bgarberman/IoTMedicine/README.md

# IoTMedicine
Firmware and PCB Design Files for IoT Medicine Monitor
