bgarberman/IoTMedicine/PCB Files/IotMedicine/ESE516_ExampleBaseProject_V1/Project Outputs for ESE516_ExampleBaseProject_V1/BOM/Bill of Materials-ESE516_ExampleBaseProject_V1.xls

Line # | Name | Description | Designator | Quantity | Manufacturer 1 | Manufacturer Part Number 1 | Manufacturer Lifecycle 1 | Supplier 1 | Supplier Part Number 1 | Supplier Unit Price 1 | Supplier Subtotal 1
 | PTS810 SJK 250 SMTR LFS | SWITCH TACTILE SPST-NO 0.05A 16V Tactile Switch SPST-NO Top Actuated Surface Mount | B1 | 1 | ITT C&K | PTS810SJK250SMTRLFS | Volume Production | Digi-Key | CKN10503CT-ND | 0.3 | 0.3
 | Cap | Capacitor | C1, C9 | 2 | Vishay Vitramon | VJ0603Y104KNXAO | Volume Production | Digi-Key | 720-1235-1-ND | 0.85 | 1.7
 | 10nF 16V | CAP 10nF 16V ±10% 0603 (1608 Metric) Thickness 1mm SMD | C4 | 1
 | 100nF 16V | CAP 100nF 16V ±10% 0603 (1608 Metric) Thickness 1mm SMD | C5, C18 | 2 | Kyocera AVX | 0603YC104KAT2A | Volume Production | Digi-Key | 478-1239-1-ND | 0.16 | 0.32
 | 4.7uF 16V | CAP 4.7uF 16V ±10% 0805 (2012 Metric) Thickness 1.45mm SMD | C6 | 1 | Kyocera AVX | 0805YD475KAT2A | Volume Production | Digi-Key | 478-5166-6-ND | 0.79 | 0.79
 | 47pF 16V | CAP 47pF 16V ±0.5pF 0603 (1608 Metric) Thickness 1mm SMD | C7, C8 | 2 | Kyocera AVX | 08051A470JAT2A | Volume Production | Digi-Key | 478-1282-6-ND | 0.19 | 0.38
 | CAP 10uF 16V | CAP 10uF 16V ±10% 0805 (2012 Metric) Thickness 1.45mm SMD | C10, C11, C12 | 3 | KEMET | C0805C106K4PAC | Volume Production
 | CAP 18pF 10V | CAP 18pF 10V ±1% 0805 (2012 Metric) Thickness 0.75mm SMD | C13, C14 | 2 | Vishay Vitramon | VJ0805A180GXQCW1BC | Volume Production | Digi-Key | 720-1709-6-ND | 0.29 | 0.58
 | CAP 1uF 16V | CAP 1uF 16V ±10% 0603 (1608 Metric) Thickness 1mm SMD | C15 | 1 | Yageo | CC0603KRX5R7BB105 | Volume Production | Digi-Key | 311-1444-1-ND | 0.18 | 0.18
 | Cap | Capacitor | C19, C21 | 2 | Murata | GRM21BR60J226ME39L | Volume Production | Digi-Key | 490-1719-1-ND | 0.46 | 0.92
 | Cap | Capacitor | C20 | 1 | Murata | GRM188R60J106ME47D | Volume Production | Future Electronics | GRM188R60J106ME47D-CUTT | 0.0834 | 0.0834
 | Cap | Capacitor | C22, C23 | 2 | Murata | GRM1885C1H221JA01D | Volume Production | Digi-Key | 490-1435-1-ND | 0.11 | 0.22
 | Cap | Capacitor | C24 | 1 | KEMET | C0603X104K5RACTU | Volume Production | Digi-Key | 399-7969-1-ND | 0.21 | 0.21
 | Cap | 4.7 uF 10V 0603 | C25 | 1 | TDK | C1608X7S1A475K080AC | Volume Production | Mouser | 810-C1608X7S1A475KAC | 0.29 | 0.29
 | Cap | Capacitor | C26 | 1 | Murata | GRM188R60J226MEA0D | Volume Production | Digi-Key | 490-7611-1-ND | 0.26 | 0.26
 | Cap | Capacitor | C27 | 1 | Murata | GRM21BR60G107ME15L | Volume Production | Digi-Key | 490-10510-6-ND | 0.97 | 0.97
 | Cap | Capacitor | C28 | 1 | Murata | GRM21BR60J226ME39L | Volume Production | Digi-Key | 490-1719-1-ND | 0.46 | 0.46
 | PRTR5V0U2X,215 | Ultra Low Capacitance Double Rail-to-Rail ESD Protection Diode, 5.5 V, 1 pF, -40 to 85 degC, 4-Pin SOT143B, RoHS, Tape and Reel | D1 | 1 | NXP Semiconductors | PRTR5V0U2X,215 | Volume Production | Digi-Key | 1727-3884-6-ND | 0.55 | 0.55
 | RGB LED | RGB LED (THT) | D2 | 1 | Kingbright | WP154A4SEJ3VBDZGC/CA | Unknown | Digi-Key | 754-2153-ND
 | LTST-C191KGKT | Chip LED, Green, 574 nm, 40 pF, -55 to 85 degC, 2-Pin SMD, RoHS, Tape and Reel | DS1 | 1 | Vishay Lite-On | LTST-C191KGKT | Volume Production | Digi-Key | 160-1446-1-ND | 0.29 | 0.29
 | BLM21PG221SN1D | Chip Ferrite Bead for Power Lines, 220 Ohm, 2000 mA, -55 to 125 degC, 2 x 1.25 x 1.05 mm SMD, Tape and Reel | FB1, FB2, FB3 | 3 | Murata | BLM21PG221SN1D | Volume Production | Digi-Key | 490-1054-6-ND | 0.1 | 0.3
 | ZX62R-B-5P | Connector; USBMicro-B,Reverse type, SMT; 5 Position; Right Angle | J1 | 1 | Hirose | ZX62R-B-5P(30) | Volume Production | Digi-Key | H125274DKR-ND | 1.02 | 1.02
 | Inductor | Inductor | L1 | 1 | Murata | DFE252012F-1R0M=P2 | Volume Production | Digi-Key | 490-13053-1-ND | 0.67 | 0.67
 | Speaker | Speaker 3" Diameter 4 Ohm 3 Watt | LS1 | 1 | Adafruit Industries | 1314 | Unknown | Digi-Key | 1528-2435-ND | 1.95 | 1.95
 | NPN | NPN Bipolar Transistor | Q1, Q2, Q3 | 3 | Diodes Zetex | DNBT8105-7 | Volume Production | Digi-Key | DNBT8105DIDKR-ND | 0.36 | 1.08
 | 27R 1% | 27R 0.1W 1% 0603 (1608 Metric) SMD | R1, R2, R17, R18, R19 | 5 | Yageo | RC0603FR-0727RL | Volume Production | Digi-Key | 311-27.0HRCT-ND | 0.024 | 0.24
 | 1K | 1K 0.1W 1% 0603 (1608 Metric) SMD | R3, R5, R20 | 3 | Panasonic | ERJ3EKF1001V | Volume Production | Digi-Key | P1.00KHCT-ND | 0.1 | 0.3
 | Jumper | Jumper 0603 (1608 Metric) | R4, R8, R12, R13, R14 | 5 | Bourns | CR0603-J/-000ELF | Volume Production | Digi-Key | CR0603-J/-000ELFDKR-ND | 0.016 | 0.16
 |  | Resistor | R6, R9, R10, R11, R33 | 5 | Vishay Dale | TNPW060310K0BEEA | Volume Production | Digi-Key | TNP10.0KAADKR-ND | 0.65 | 3.25
 | 39R | 39R 0.125W 5% 0805 (2012 Metric) SMD | R7 | 1 | Yageo | RC0805JR-0739RL | Volume Production | Digi-Key | 311-39ARDKR-ND | 0.1 | 0.1
 | 10K | Resistor | R15, R16 | 2 | Vishay Dale | TNPW060310K0BEEA | Volume Production | Digi-Key | TNP10.0KAADKR-ND | 0.65 | 1.3
 | Res1 | Resistor | R21, R22, R23, R27, R28, R29 | 6 | Yageo | RC0603FR-071KL | Volume Production | Digi-Key | 311-1.00KHRDKR-ND | 0.024 | 0.24
 | Res1 | Resistor | R24, R25, R26 | 3 | Panasonic | ERA6AEB101V | Volume Production | Digi-Key | P100DACT-ND | 0.36 | 1.08
 | 100 | Resistor (100) | R30, R32 | 2 | Panasonic | ERA6AEB101V | Volume Production | Digi-Key | P100DACT-ND | 0.36 | 0.72
 | RPot | Potentiometer | R31 | 1 | Bourns | 3310Y-001-103L | Volume Production | Digi-Key | 3310Y-001-103L-ND | 2.9 | 2.9
 | Res1 | Resistor | R35 | 1 | Vishay Dale | CRCW0402100KFKEDHP | Volume Production | Digi-Key | 541-100KYDKR-ND | 0.15 | 0.15
 | Res1 | Resistor | R36 | 1 | Panasonic | ERJ6ENF4533V | Volume Production | Digi-Key | P453KCCT-ND | 0.1 | 0.1
 | 30k | Resistor | R37 | 1 | Panasonic | ERA-6AEB303V | Volume Production | Digi-Key | P30KDACT-ND | 0.36 | 0.36
 | FSR | Force Sensing Resistor | R38 | 1 | Adafruit Industries | 1075 | Unknown | Arrow | 1075 | 10.2 | 10.2
 | 150080SS75000 | SMD mono-color Chip LED, WL-SMCW, Super Red | Red1 | 1 | Wurth Electronics | 150080SS75000 | Volume Production
 | 104031-0811 | Micro SD Card, RA, -25 to 85 degC, 8-Pin SMD, RoHS, Tape and Reel | SD1 | 1 | Molex | 104031-0811 | Volume Production | Digi-Key | WM6357CT-ND | 2.02 | 2.02
 | FT234XD-R | FT234XD USB to BASIC UART IC, -40 to +85 degC, 12-Pin DFN, Pb-Free, Tape and Reel | U1 | 1 | FTDI | FT234XD-R | Volume Production | Digi-Key | 768-1178-6-ND | 2.04 | 2.04
 | 20021111-00010T4LF | CONN HEADER 10POS UNSHD VERT T/H | U2 | 1 | Amphenol FCI | 20021111-00010T4LF | Volume Production | Digi-Key | 609-3712-ND | 0.67 | 0.67
 | SAMW25H18-MR510PB | RF TXRX MODULE WIFI TRACE ANT | U3 | 1 | Microchip / Atmel | ATSAMW25H18-MR510PB | Volume Production | Digi-Key | ATSAMW25H18-MR510PB-ND | 19.15 | 19.15
 | AT25DF081A-SSH-T | IC FLASH 8MBIT 100MHZ 8SOIC | U4 | 1 | Adesto Technologies | AT25DF081A-SSH-T | Not Recommended for New Design | Digi-Key | 1265-1166-1-ND | 1.26 | 1.26
 | Class D Amp | 2.5W Filterless Class-D Mono Audio Amplifier | U5 | 1 | Diodes | PAM8302AASCR | Volume Production | Digi-Key | PAM8302AASCRDICT-ND | 0.63 | 0.63
 | Real-Time Clock | Extremely Accurate I2C-Integrated RTC/TCXO/Crystal | U6 | 1 | Maxim | DS3231S#T&R | Volume Production | Digi-Key | DS3231S#T&RCT-ND | 7.87 | 7.87
 | TLV62568DRL | This is a buck/boost converter designed by Texas Instruments | U9 | 1 | Texas Instruments | TLV62568ADRLR | Unknown | Digi-Key | 296-50407-1-ND | 1.14 | 1.14
 | TLE2426CDR | Rail Splitter IC | U10 | 1 | Texas Instruments | TLE2426CDR | Volume Production | Digi-Key | 296-26774-1-ND | 2.14 | 2.14
 | 14340272-32.768KHz | Crystal, 32.768 KHz, -40 to 85 degC, 3.2 x 1.5 x 0.9 mm SMD | X1 | 1 | Abracon | ABS09-32.768KHZ-T | Volume Production | Digi-Key | 535-9539-1-ND | 1.23 | 1.23
