bgarberman/IoTMedicine/PCB Files/IotMedicine/ESE516_ExampleBaseProject_V1/Project Outputs for ESE516_ExampleBaseProject_V1/Job1.PDF

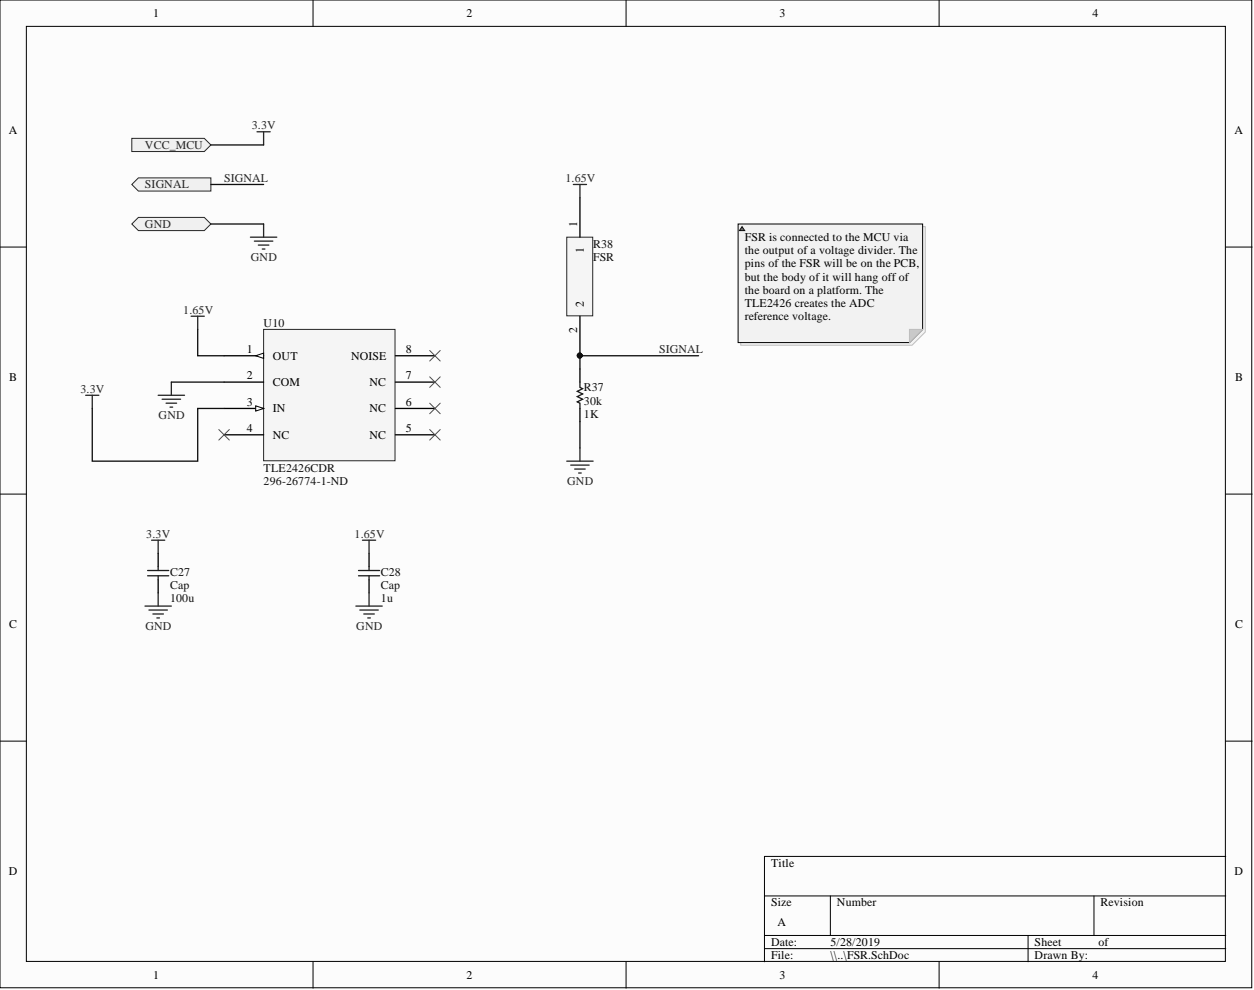
[picture p1: page 2]

FSR is connected to the MCU via
the output of a voltage divider. The
pins of the FSR will be on the PCB,
but the body of it will hang off of
the board on a platform. The
TLE2426 creates the ADC
reference voltage.

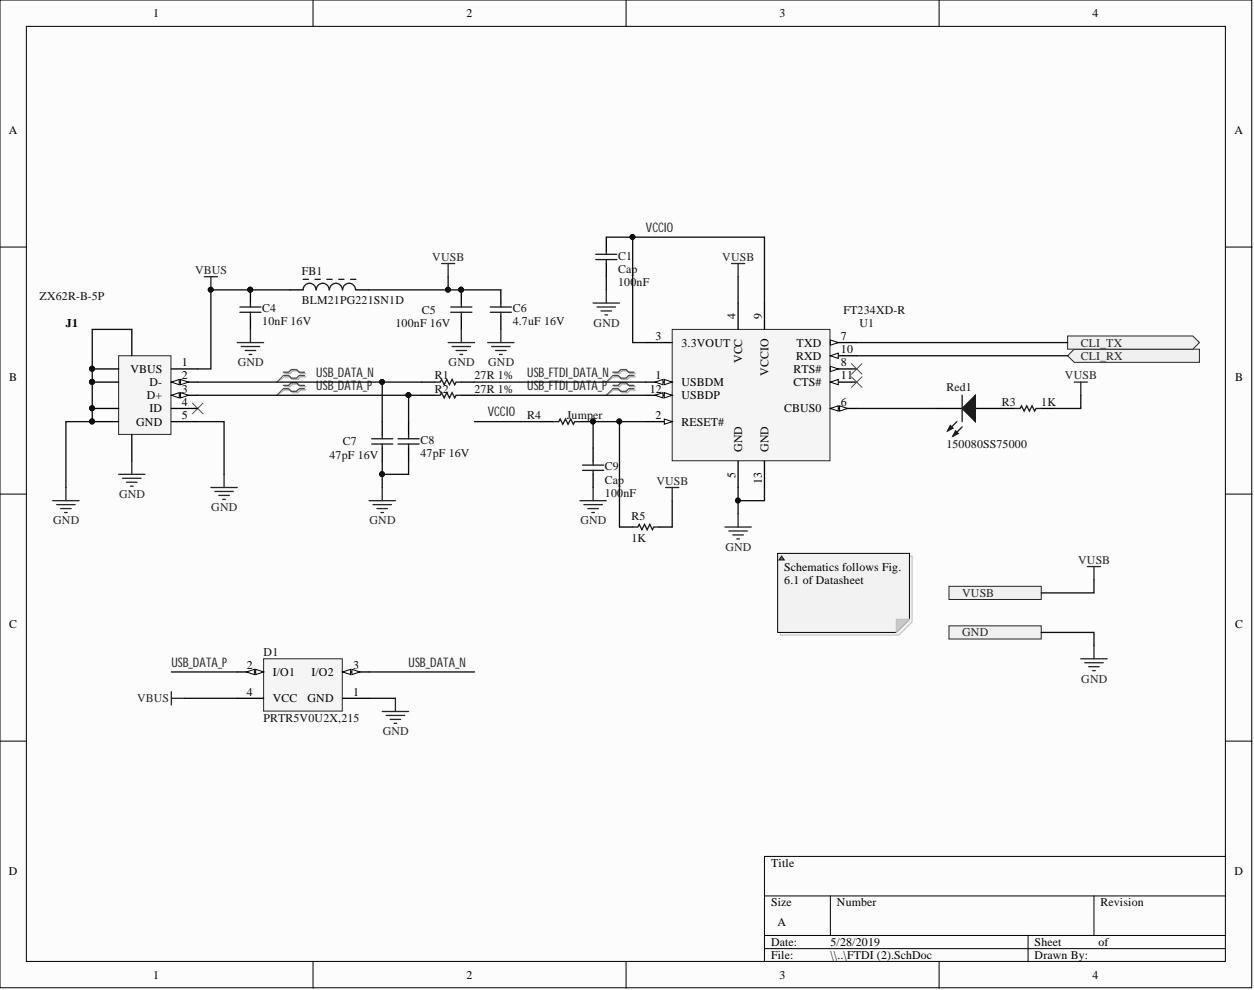
[picture p2: page 3]

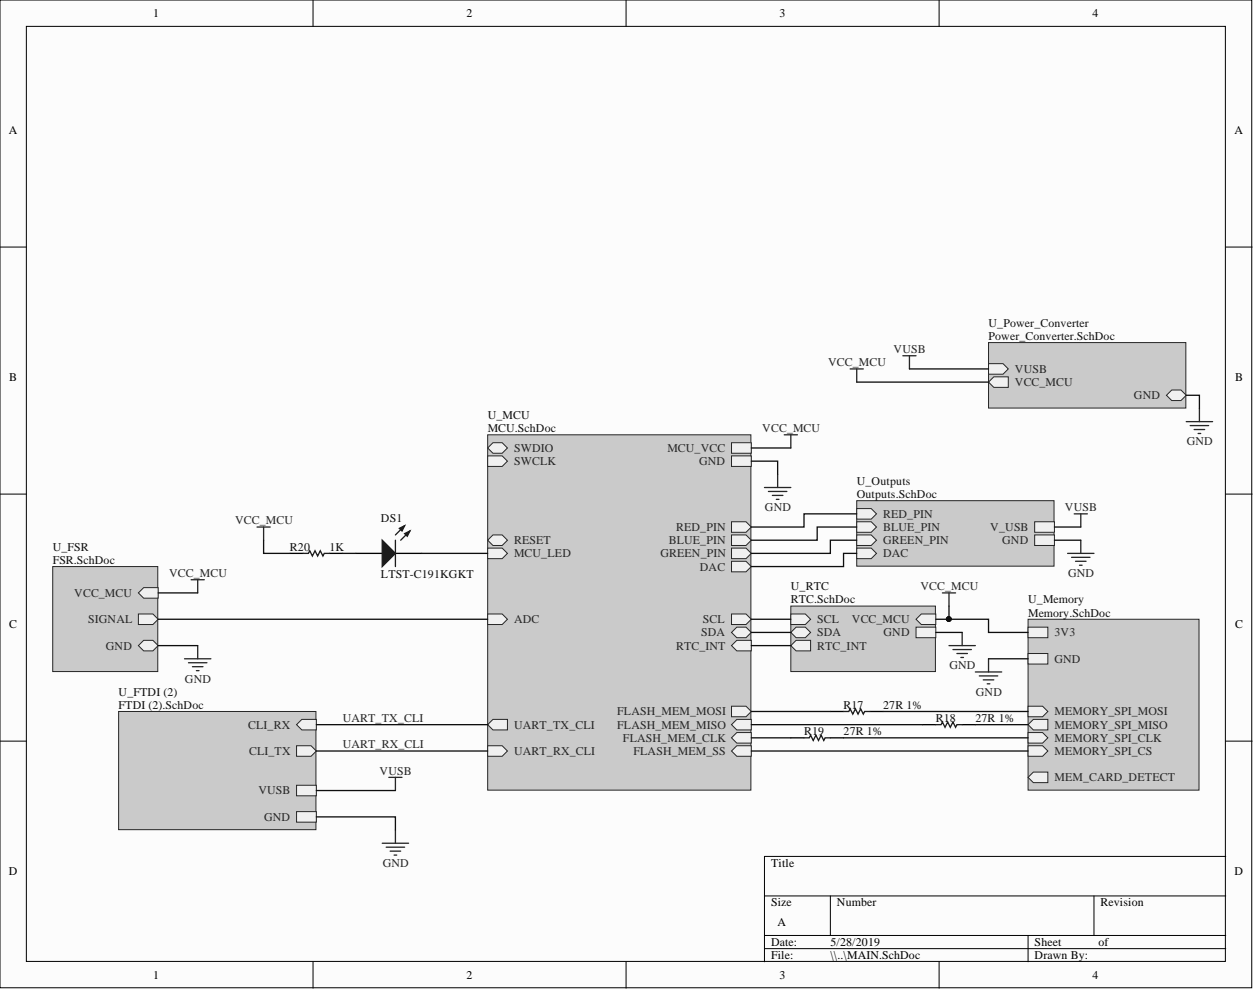
[picture p3: page 4]

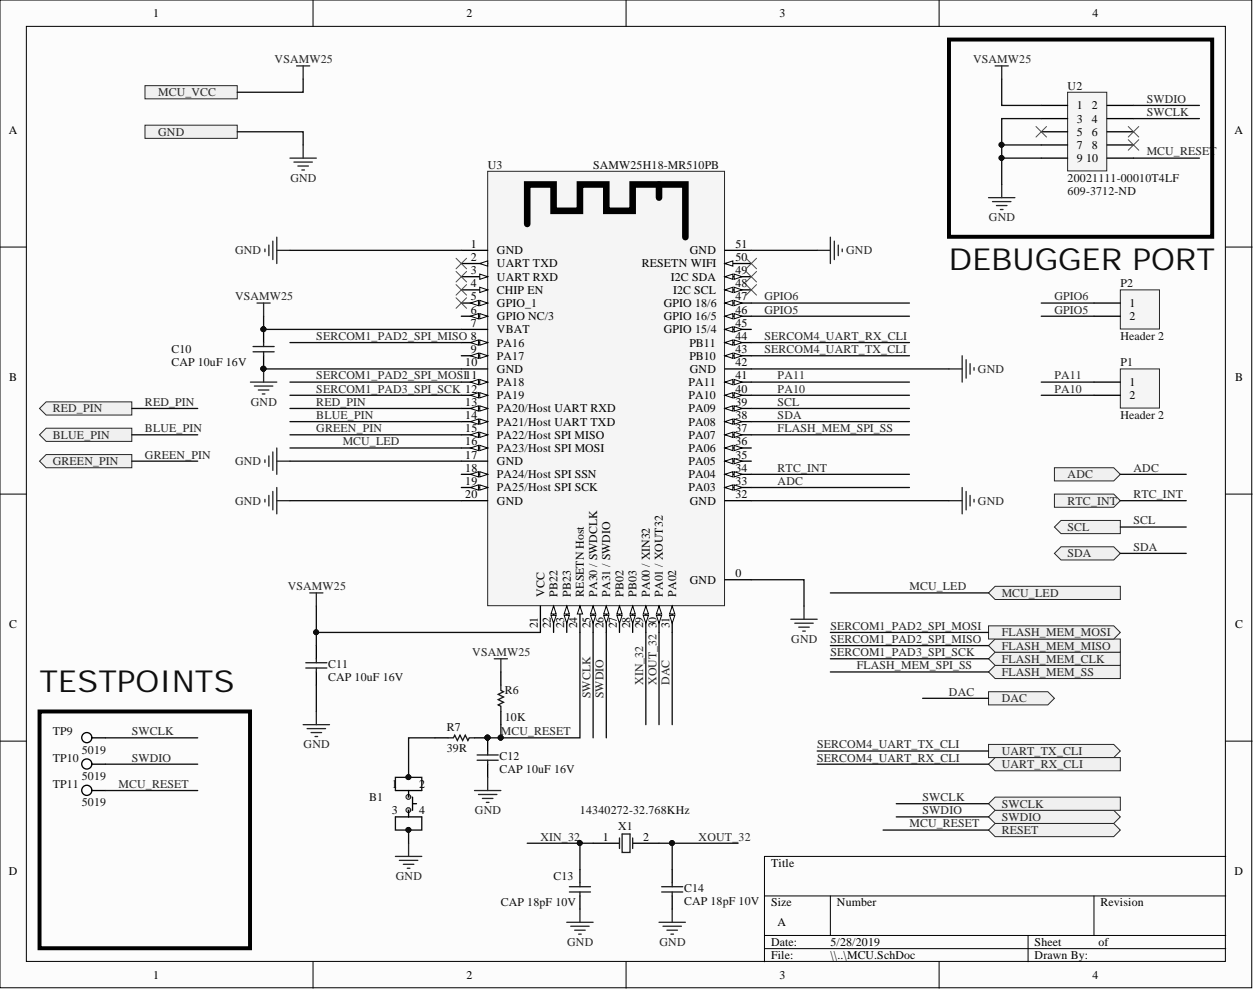
[picture p4: page 5]

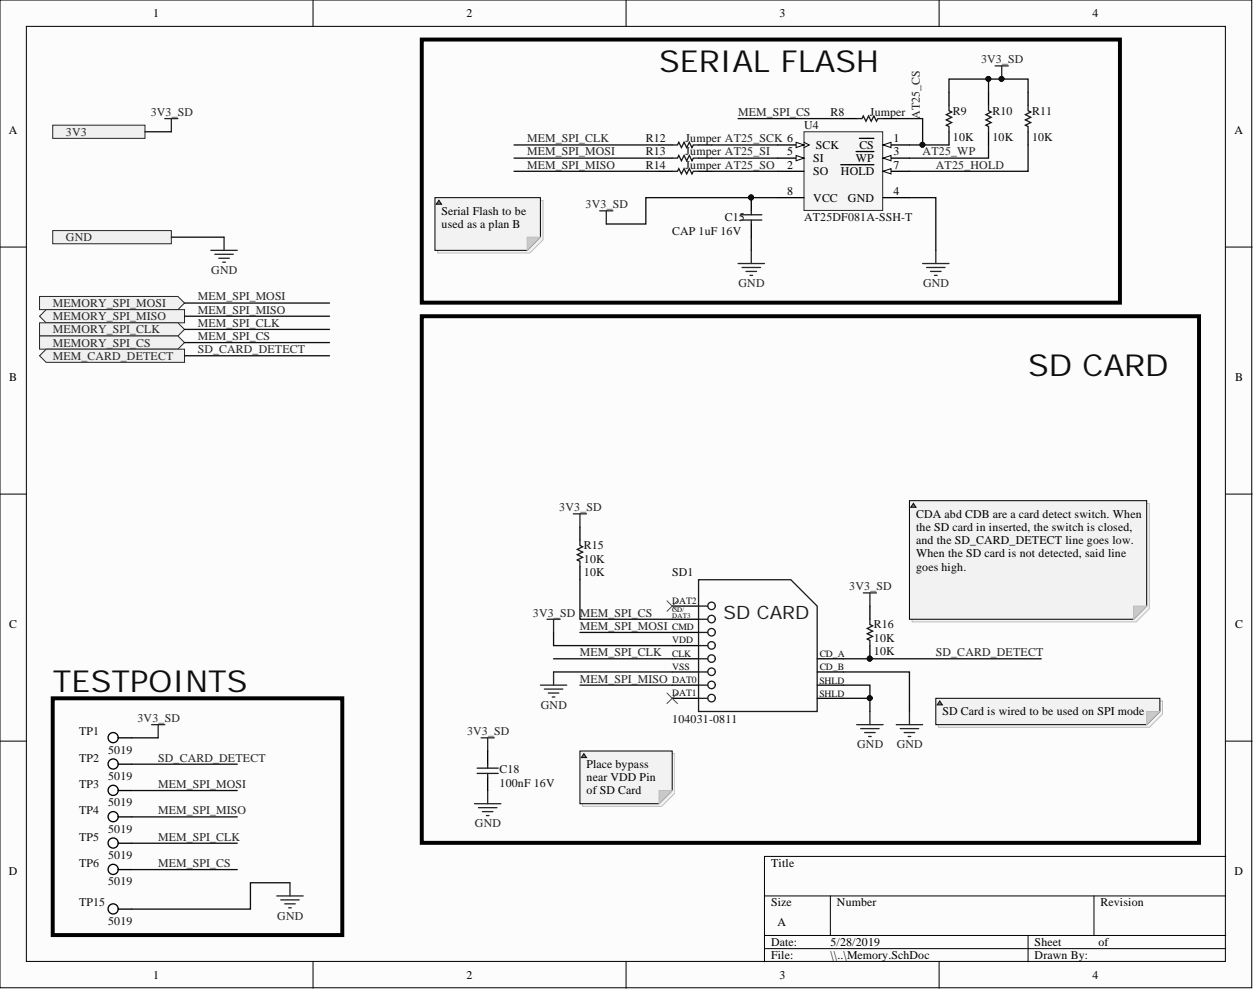
[picture p5: page 6]

Serial Flash to be
used as a plan B

CDA abd CDB are a card detect switch. When
the SD card in inserted, the switch is closed,
and the SD_CARD_DETECT line goes low.
When the SD card is not detected, said line
goes high.

SD Card is wired to be used on SPI mode

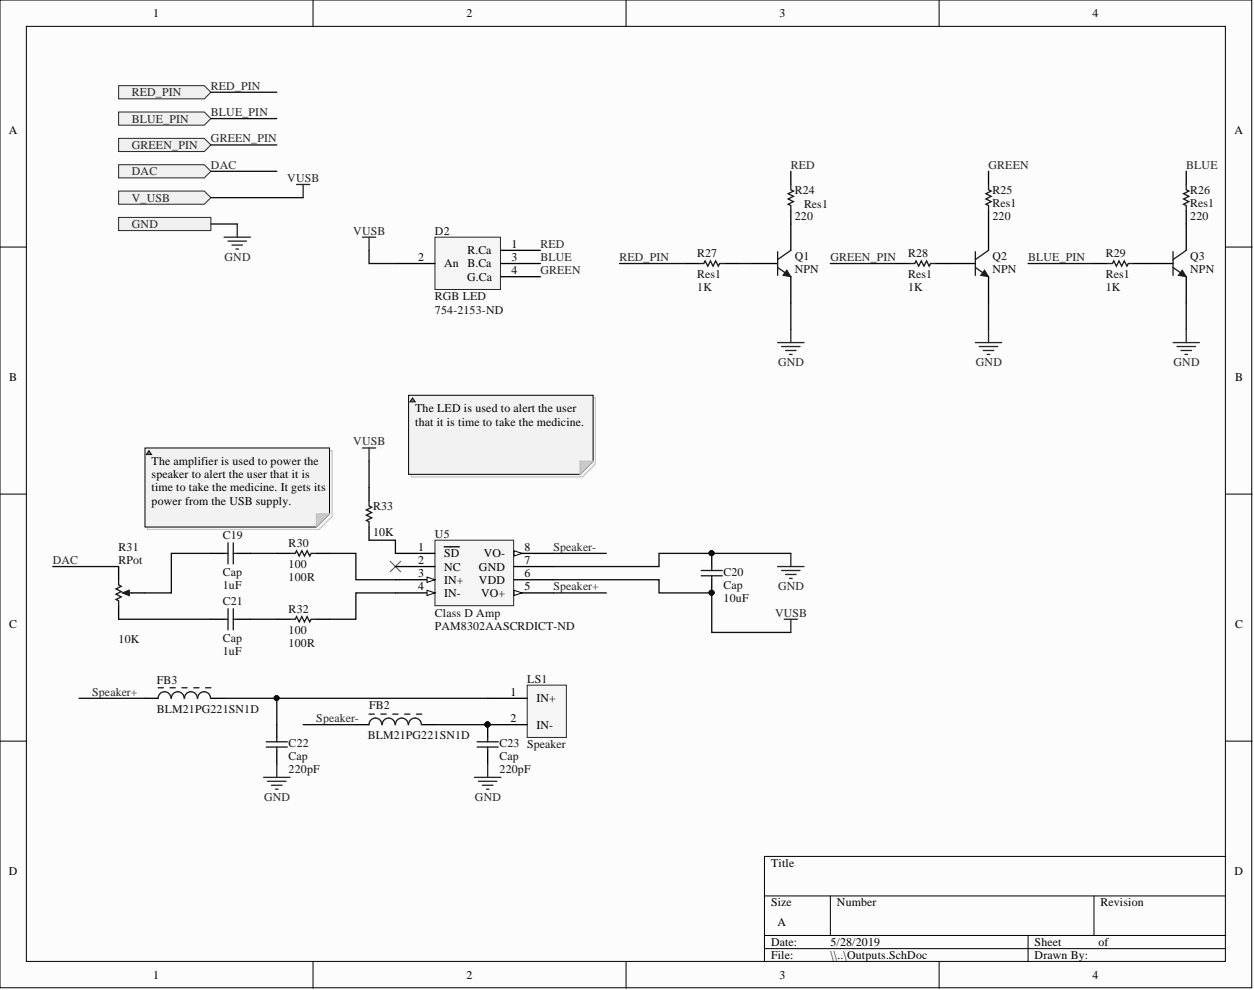
[picture p6: page 7]

The LED is used to alert the user
that it is time to take the medicine.

The amplifier is used to power the
speaker to alert the user that it is
time to take the medicine. It gets its
power from the USB supply.

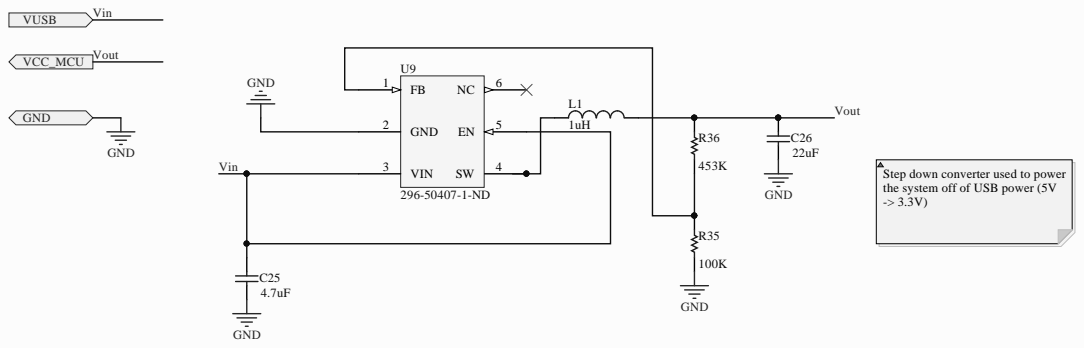
[picture p7: page 8]

tem off of USB p

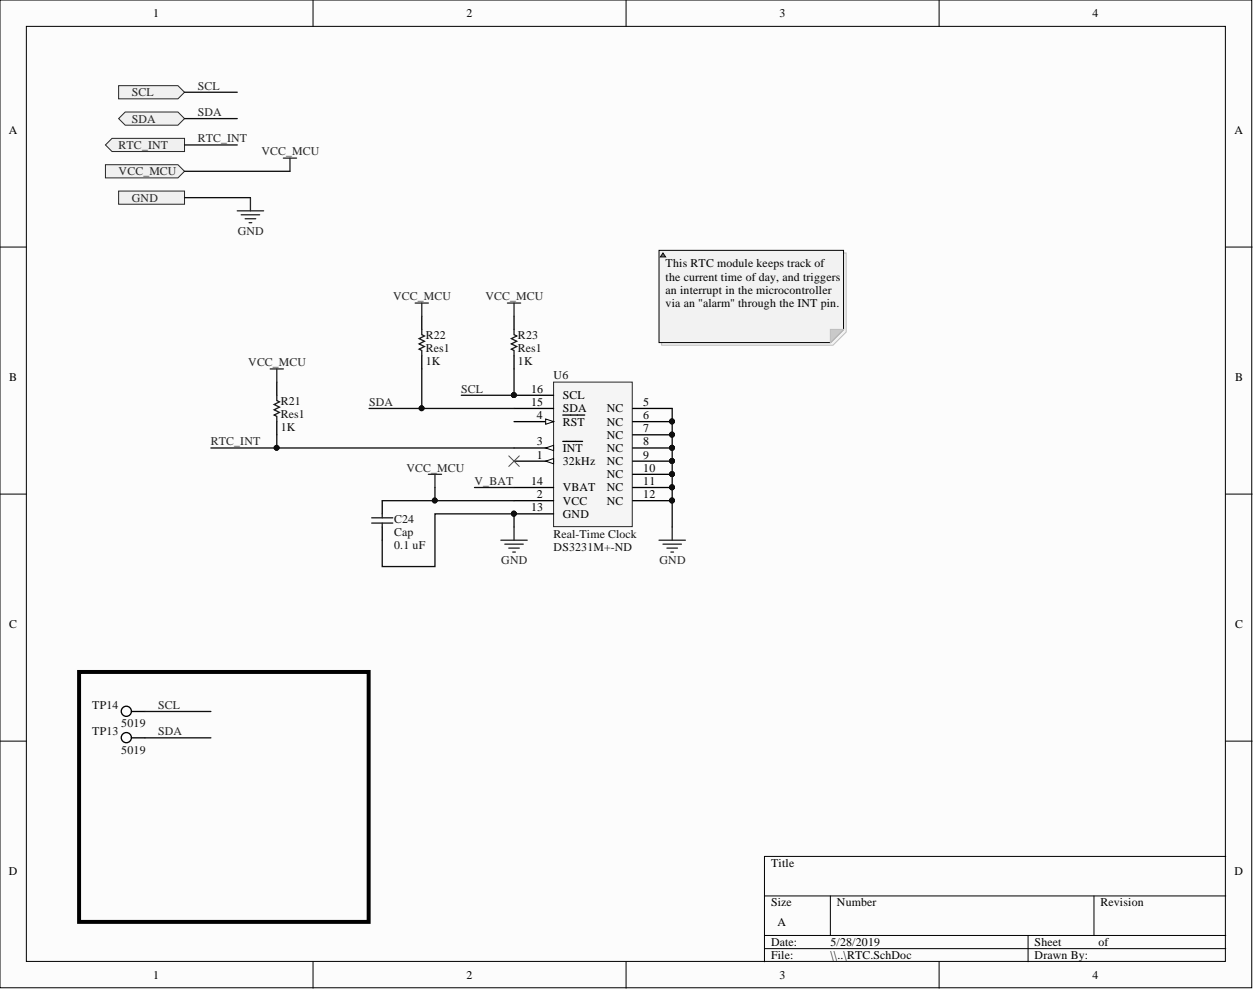
[picture p8: page 9]

This RTC module keeps track of
the current time of day, and triggers
an interrupt in the microcontroller
via an "alarm" through the INT pin.

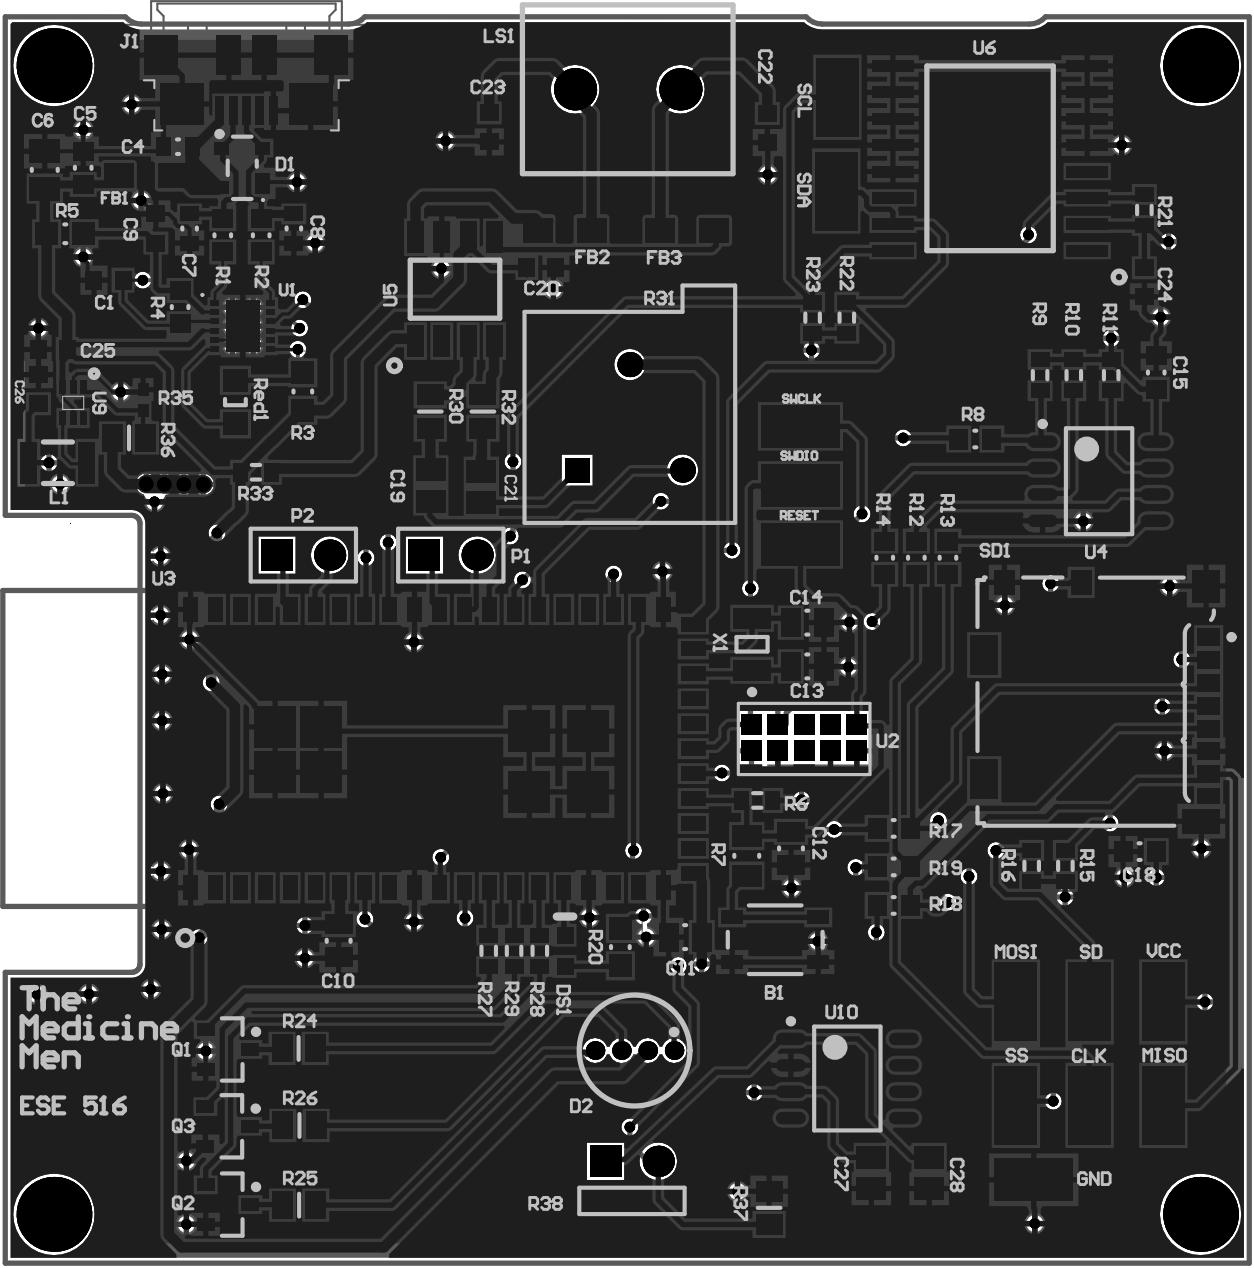
[picture p9: page 10]
