bgarberman/IoTMedicine/(list of files, drawings)

Other design files:
PCB Files/ESE516_BareBoardTemplate.PcbDoc
PCB Files/Iot_Medicine.PcbLib
PCB Files/Iot_Medicine.SchLib
PCB Files/IotMedicine/ESE516_ExampleBaseProject_V1/ESE516_ExampleBaseProject_V1.PrjPcb
PCB Files/IotMedicine/ESE516_ExampleBaseProject_V1/FSR.SchDoc
PCB Files/IotMedicine/ESE516_ExampleBaseProject_V1/FTDI (2).SchDoc
PCB Files/IotMedicine/ESE516_ExampleBaseProject_V1/MAIN.SchDoc
PCB Files/IotMedicine/ESE516_ExampleBaseProject_V1/MCU.SchDoc
PCB Files/IotMedicine/ESE516_ExampleBaseProject_V1/Memory.SchDoc
PCB Files/IotMedicine/ESE516_ExampleBaseProject_V1/Outputs.SchDoc
PCB Files/IotMedicine/ESE516_ExampleBaseProject_V1/Power_Converter.SchDoc
PCB Files/IotMedicine/ESE516_ExampleBaseProject_V1/RTC.SchDoc
